DropletKitchen/strobe/(notices)

Notices in the files:
files/strobing.ino:
The Center for New Music and Audio Technologies,
University of California, Berkeley. Copyright (c) 2008-14, The Regents of
the University of California (Regents).
